huuvietnguyen72/fall-detection/requirements-yolo.txt

# Tùy chọn: chỉ cần nếu muốn chạy Vision Node với --backend yolo
ultralytics
