huuvietnguyen72/fall-detection/(commit log)

2026-11-06 Hệ thống giám sát và phát hiện té ngã thời gian thực
    Firmware ESP32 (MPU6050 + Edge Impulse TinyML), vision MediaPipe, server
    fusion MQTT + dashboard, Telegram SOS, simulator, tests và công cụ đánh giá SisFall.
2026-11-06 Hướng dẫn từng bước cho macOS/Windows và công cụ fine-tune bằng đai
    - README: hướng dẫn cài đặt, nạp firmware, cấu hình và fine-tune ở đầu file
    - tinyml/belt_collect.py: thu dữ liệu từ đai qua USB, xuất CSV Edge Impulse
    căn đỉnh va chạm, chấm ngưỡng bằng đúng mã firmware
    - flash.py nhận cổng COM trên Windows; run.py tìm Mosquitto trên Windows
    và in UTF-8 trên console Windows
2026-11-07 Thêm sơ đồ đấu dây ESP32 và hướng dẫn lắp mạch
2026-11-07 Thêm sơ đồ mạch Wokwi và sketch thử linh kiện
    Đã chạy mô phỏng: quét I2C thấy 0x3C (OLED) và 0x68 (MPU6050), LED, còi, nút đều đúng chân.
2026-11-10 Firmware: sửa lỗi không đọc được cảm biến và hỗ trợ module MPU6500
    - read_mpu(): lambda tên `word` bị macro word(...) -> makeWord() của
    Arduino-ESP32 che mất, nên luôn trả về chính chỉ số byte (0, 2, 4, 8,
    10, 12) thay vì dữ liệu cảm biến -> |a| ~ 0 g, đai không bao giờ phát
    hiện được ngã. Đổi tên thành be16.
    - Khởi tạo cảm biến bằng thanh ghi trực tiếp thay cho Adafruit_MPU6050:
    nhiều module "GY-521" thực chất dùng MPU6500/MPU9250 (WHO_AM_I 0x70/0x71...)
    mà thư viện Adafruit từ chối. Giữ nguyên cấu hình: ±16 g, ±2000 °/s,
    lọc ~21 Hz (thêm ACCEL_CONFIG2 cho MPU6500). In WHO_A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
2026-11-10 Firmware: sửa lỗi giữ nút 8 s / lệnh wifi không mở được trang cấu hình
    Khi đai còn lưu một WiFi không có trong vùng phủ sóng, maintain_wifi()
    cứ 15 s lại gọi WiFi.begin(). Mở portal lúc STA đang "connecting" khiến
    ESP-IDF báo "sta is connecting, cannot set config" hàng nghìn lần (ngập
    Serial, làm chậm loop) và AP FallBelt-Setup không lên.
    open_portal() giờ dừng kết nối STA (giữ nguyên WiFi đã lưu) và ngắt MQTT
    trước khi bật portal.
    Đã kiểm tra trên ESP32 thật: 0 dòng lỗi, AP FallBelt-Setup hiện ngay.
2026-11-10 Thu dữ liệu fine-tune qua WiFi (không cần dây USB)
    Firmware:
    - Mở cổng TCP DATA_TCP_PORT (2323, config.h; 0 = tắt) khi đã có WiFi.
    Luồng CSV giống hệt lệnh `data` qua Serial, cờ bật/tắt riêng cho TCP.
    - Gửi không chặn (MSG_DONTWAIT): PC đọc không kịp thì bỏ mẫu và đếm lại
    (`info` -> "bo mau"), không bao giờ làm đứng vòng phát hiện té ngã.
    Dòng gửi dở được kết thúc bằng "\n" để PC bỏ qua.
    - Qua TCP chỉ nhận lệnh `data`: factory/reboot/fall... chỉ dùng qua USB,
    máy lạ trong LAN không điều khiển được đai.
    tinyml/belt_collect.py:
    - --port nhận IP / belt01.local / socket://... (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
    [belt_collect.py, config.h, fall_belt.ino]
2026-11-10 Chấm điểm model/firmware (tools/ei_host) chạy được trên Windows
    - build.py: SKIP so khớp bằng p.as_posix() (trước đây str(p) dùng "\" nên
    không lọc được CMSIS/porting... và CMSIS vượt MAX_PATH -> lỗi biên dịch);
    tên file chạy thêm ".exe" trên Windows để cache hoạt động.
    - stream.cpp, runner.cpp (--binary): chuyển stdin/stdout sang chế độ nhị
    phân trên Windows; chế độ văn bản cắt dữ liệu ở byte 0x1A và đổi \r\n
    nên stream.exe thoát với mã 1.
    Đã kiểm tra với g++ của MSYS2 (ucrt64): `belt_collect.py eval --grid`
    chạy đúng; pytest 28 đạt, 2 bỏ qua (cần dữ liệu SisFall).
    Co-Aut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
2026-11-10 Đổi chân nút/LED, TRIGGER_G 1.8 và cập nhật tài liệu
    - Chân theo mạch đai thật: nút GPIO33 -> GPIO4, LED đỏ 26 -> 27,
    LED xanh 27 -> 26. Cập nhật README (bước 3, bảng 2.1) và sơ đồ Wokwi
    (diagram.json, sketch.ino). docs/wiring.svg vẫn vẽ chân cũ: README có
    ghi chú, cần vẽ lại.
    - TRIGGER_G 2.0 -> 1.8: chấm bằng `belt_collect.py eval --grid` trên dữ
    liệu đai thật (26 lần ngã hợp lệ, 30 lần sinh hoạt): bắt ngã 88% -> 96%,
    báo nhầm giữ nguyên 7%.
    - README: thu dữ liệu qua WiFi (--port <IP đai>), dùng g++ của MSYS2 để
    chấm điểm trên Windows thay cho WSL, ghi chú module MPU6500, mẹo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
2026-11-10 Dashboard: video camera mượt (MJPEG) và camera mạng không trễ dồn
    - Server thêm /stream.mjpg; dashboard hiển thị luồng thay vì tải 1 ảnh/giây
    - Vision gửi ảnh xem trước 12 FPS, rộng 640 px (PREVIEW_FPS, PREVIEW_WIDTH trong .env)
    - Luồng đọc camera riêng chỉ giữ khung mới nhất: iPhone phát 30 FPS mà nhận diện ~14 FPS
    thì hình không còn trễ dần
    - Camera mạng chưa sẵn sàng / rớt kết nối: chờ và tự kết nối lại thay vì thoát
    - Ẩn mật khẩu trong URL camera khi in log
2026-11-10 Sửa bộ làm mượt tư thế: người nằm bị mất dấu xen kẽ vẫn được xác nhận NẰM
    Bản cũ chỉ đổi tư thế khi tư thế mới xuất hiện LIÊN TỤC, một khung mất dấu là đếm lại.
    MediaPipe mất dấu người nằm trên sàn ~30% số khung (URFD), nên hệ thống giữ nguyên ĐỨNG
    trong khi người đang nằm; fusion có thể hiểu nhầm thành "đã đứng dậy" và bỏ qua cú ngã thật.
    Bản mới bỏ phiếu theo cửa sổ thời gian: tư thế mới >= 60% số khung CÓ thấy người;
    khung mất dấu không bỏ phiếu. Trên URFD (ảnh gốc): recall NẰM 25.7% -> 44.1%,
    precision 89.1% -> 90.5%, chuỗ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
2026-11-10 Cài đặt một lệnh trên máy mới (macOS/Linux/Windows)
    - scripts/setup.sh, scripts/setup.ps1: tạo .venv, cài thư viện, tạo .env, tải model
    MediaPipe, kiểm tra Mosquitto, chạy test
    - Tải model qua HTTPS bằng certifi: Python cài từ python.org trên macOS không còn lỗi
    CERTIFICATE_VERIFY_FAILED (camera không khởi động được)
    - .gitignore: cho phép đưa dữ liệu thu bằng đai (data/belt/) lên repo
    - flash.py --compile-only in cả mức dùng RAM
    - Ngưỡng mặc định của các script đánh giá = firmware (TRIGGER_G 1.8)
2026-11-10 Tài liệu kỹ thuật + số liệu thực nghiệm cho bài báo và poster; viết lại README
    - docs/BAO_CAO_KY_THUAT.md: kiến trúc, giao thức MQTT, thuật toán (đai, camera, fusion),
    thông số phần cứng (tần số lấy mẫu, năng lượng ước tính theo datasheet, kích thước,
    37% flash / 16% RAM), kết quả, hạn chế, tài liệu tham khảo
    - report/: script sinh lại mọi số liệu và hình
    - ai_metrics.py: confusion matrix + Accuracy/Precision/Recall/F1 (SisFall, dữ liệu đai)
    - vision_eval.py: camera trên URFD trong 6 điều kiện + ảnh minh họa nhận diện
    - latency_bench.py: độ trễ từng chặng (broker/server riê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
2026-11-11 Thêm dữ liệu thu từ thiết bị đeo hông (data/belt)
    - data/belt/ei: 158 mẫu CSV đã gắn nhãn Fall/Normal theo định dạng Edge Impulse
    - data/belt/raw: 65 bản ghi IMU thô (ax,ay,az,gx,gy,gz)
    - .gitignore: vẫn bỏ qua data/ nhưng giữ lại data/belt/
    [Fall.20261110-230743.csv, Fall.20261110-230848.csv, Fall.20261110-230939.csv, Fall.20261110-231020.csv, Fall.20261110-231052.csv, Fall.20261110-231139.csv, Fall.20261110-231207.csv, Fall.20261110-231238.csv]
